Atmmt/quadrotor/电调/AM32_AI8051U-main/docs/pcb/kicad/Am32stc8051u.kicad_pcb

## KiCad design 电调/AM32_AI8051U-main/docs/pcb/kicad/Am32stc8051u.kicad_pcb (2026-05-19, last stored version)

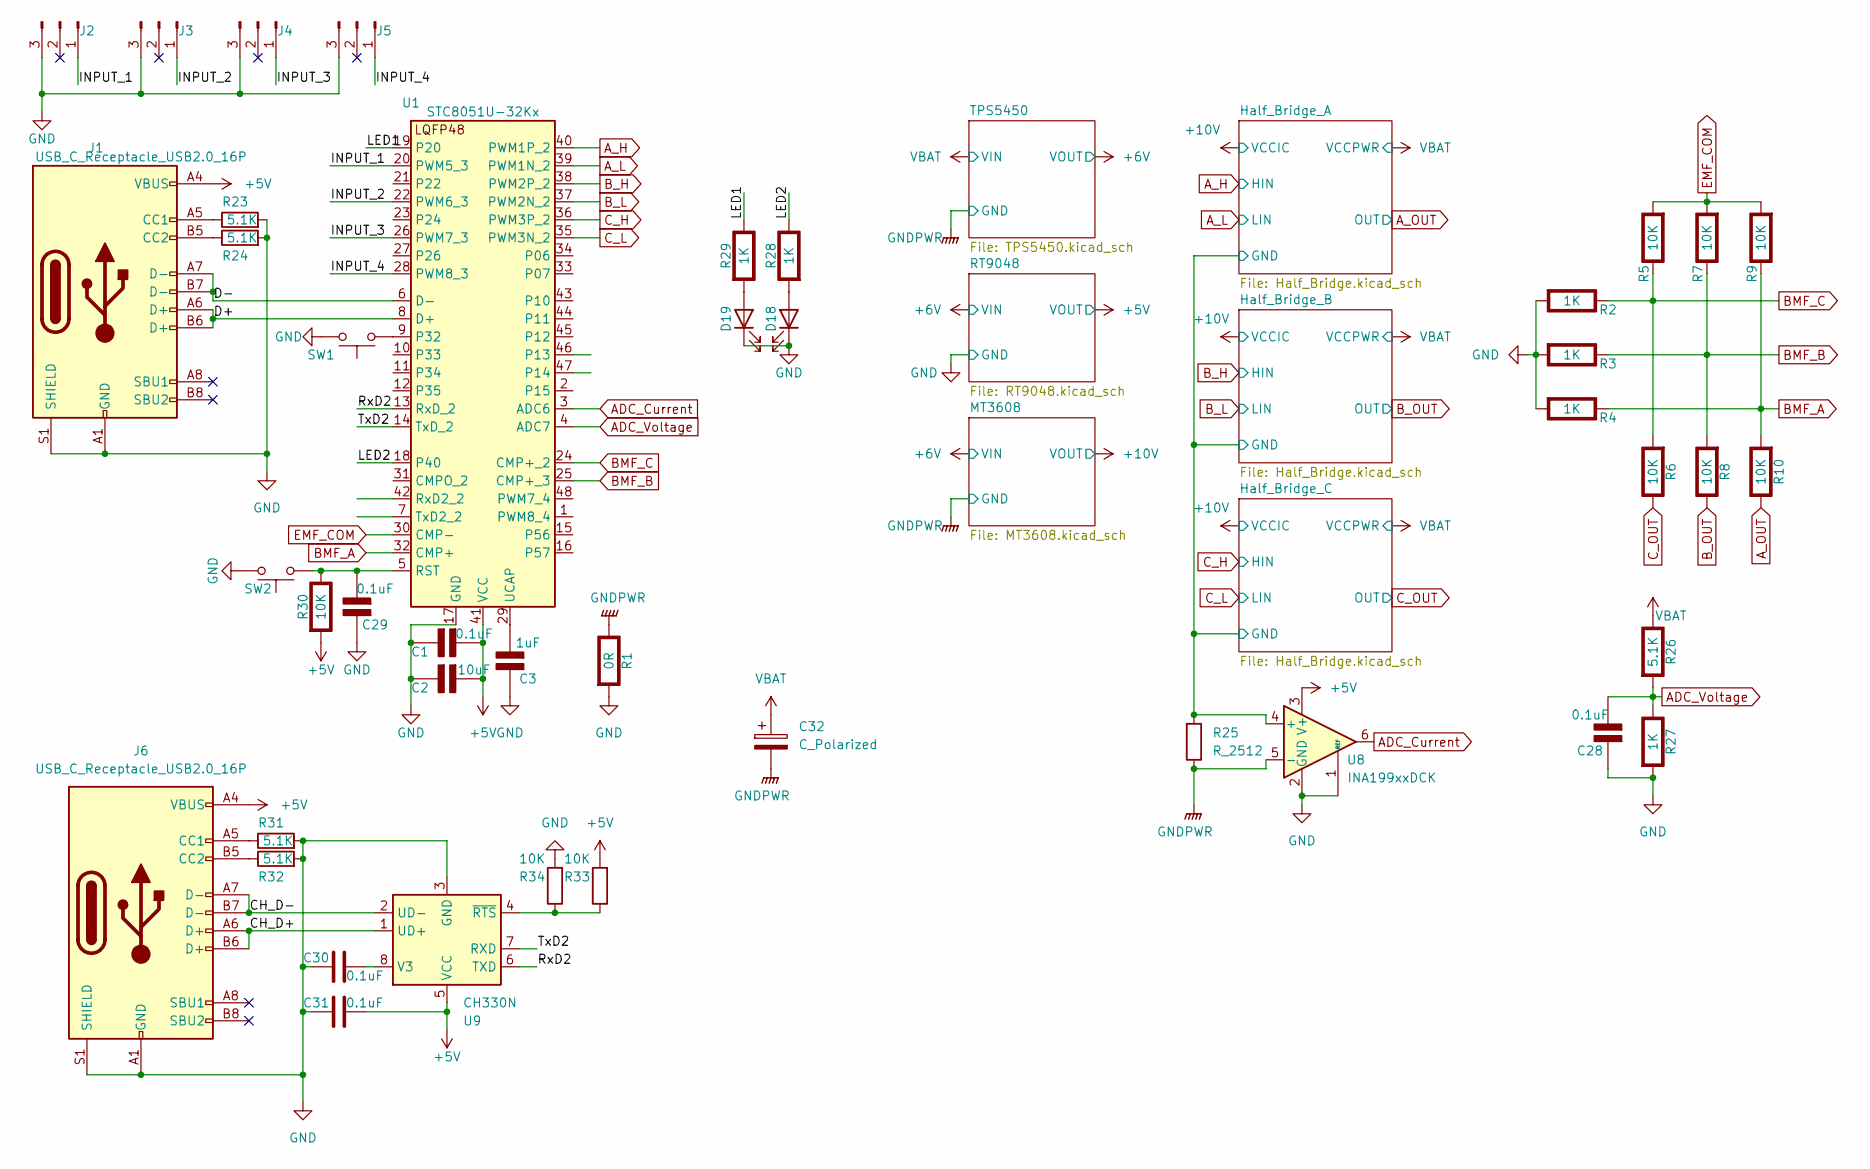
[picture p1: schematic Am32stc8051u.kicad_sch]

Parts:
C1, C28, C29: 0.1uF; C_0603_1608Metric_Pad1.08x0.95mm_HandSolder; Rating V
C2: 10uF; C_0603_1608Metric_Pad1.08x0.95mm_HandSolder; Rating V
C3: 1uF; C_0603_1608Metric_Pad1.08x0.95mm_HandSolder; Rating V
C30, C31: 0.1uF; C_0603_1608Metric_Pad1.08x0.95mm_HandSolder
C32: C_Polarized; CP_Radial_D10.0mm_P5.00mm
D18, D19: LED; LED_0603_1608Metric_Pad1.05x0.95mm_HandSolder
J1, J6: USB_C_Receptacle_USB2.0_16P; USB_C_Receptacle_GCT_USB4105-xx-A_16P_TopMnt_Horizontal
J2, J3, J4, J5: Conn_01x03_Pin; PinHeader_1x03_P2.54mm_Vertical
R1: 0R; R_0603_1608Metric_Pad0.98x0.95mm_HandSolder; Rating W
R2, R3, R4, R27, R28, R29: 1K; R_0603_1608Metric_Pad0.98x0.95mm_HandSolder; Rating W
R5, R6, R7, R8, R9, R10, R30: 10K; R_0603_1608Metric_Pad0.98x0.95mm_HandSolder; Rating W
R23, R24, R31, R32: 5.1K; R_0603_1608Metric_Pad0.98x0.95mm_HandSolder
R25: R_2512; R_2512_6332Metric
R26: 5.1K; R_0603_1608Metric_Pad0.98x0.95mm_HandSolder; Rating W
R33, R34: 10K; R_0603_1608Metric_Pad0.98x0.95mm_HandSolder
SW1, SW2: SW_Push; SW_SPST_CK_RS282G05A3
U1: STC8051U-32Kx; LQFP-48_7x7mm_P0.5mm
U8: INA199xxDCK; SOT-363_SC-70-6
U9: CH330N; SOIC-8_3.9x4.9mm_P1.27mm

Connections:
+5V: C1.1 (+), C2.1 (+), C31.2, J1.A4 (VBUS), J1.A9 (VBUS), J1.B4 (VBUS), J1.B9 (VBUS), J6.A4 (VBUS), J6.A9 (VBUS), J6.B4 (VBUS), J6.B9 (VBUS), R30.2 (-), R33.2, U1.41 (VCC), U8.3 (V+), U9.5 (VCC); also elsewhere on the board
/CH_D+: J6.A6 (D+), J6.B6 (D+), U9.1 (UD+)
/CH_D-: J6.A7 (D-), J6.B7 (D-), U9.2 (UD-)
/D+: J1.A6 (D+), J1.B6 (D+), U1.8 (D+)
/D-: J1.A7 (D-), J1.B7 (D-), U1.6 (D-)
/Half_Bridge_A/GND: R25.1, U8.4 (+); also elsewhere on the board
/INPUT_1: J2.1, U1.20 (PWM5_3)
/INPUT_2: J3.1, U1.22 (PWM6_3)
/INPUT_3: J4.1, U1.26 (PWM7_3)
/INPUT_4: J5.1, U1.28 (PWM8_3)
/LED1: R29.1 (+), U1.19 (P20)
/LED2: R28.1 (+), U1.18 (P40)
/RxD2: U1.13 (RxD_2), U9.6 (TXD)
/TxD2: U1.14 (TxD_2), U9.7 (RXD)
ADC_Current: U1.3 (ADC6), U8.6
ADC_Voltage: C28.2 (-), R26.2 (-), R27.1 (+), U1.4 (ADC7)
A_H: U1.40 (PWM1P_2); also elsewhere on the board
A_L: U1.39 (PWM1N_2); also elsewhere on the board
A_OUT: R10.1 (+); also elsewhere on the board
BMF_A: R4.1 (+), R9.1 (+), R10.2 (-), U1.32 (CMP+)
BMF_B: R3.1 (+), R7.1 (+), R8.2 (-), U1.25 (CMP+_3)
BMF_C: R2.1 (+), R5.1 (+), R6.2 (-), U1.24 (CMP+_2)
B_H: U1.38 (PWM2P_2); also elsewhere on the board
B_L: U1.37 (PWM2N_2); also elsewhere on the board
B_OUT: R8.1 (+); also elsewhere on the board
C_H: U1.36 (PWM3P_2); also elsewhere on the board
C_L: U1.35 (PWM3N_2); also elsewhere on the board
C_OUT: R6.1 (+); also elsewhere on the board
EMF_COM: R5.2 (-), R7.2 (-), R9.2 (-), U1.30 (CMP-)
GND: C1.2 (-), C2.2 (-), C3.1 (+), C28.1 (+), C29.1 (+), C30.1, C31.1, D18.1 (K), D19.1 (K), J1.A1 (GND), J1.A12 (GND), J1.B1 (GND), J1.B12 (GND), J1.S1 (SHIELD), J2.3, J3.3, J4.3, J5.3, J6.A1 (GND), J6.A12 (GND), J6.B1 (GND), J6.B12 (GND), J6.S1 (SHIELD), R1.2 (-), R2.2 (-), R3.2 (-), R4.2 (-), R23.2, R24.2, R27.2 (-), R31.2, R32.2, R34.2, SW1.1, SW2.1, U1.17 (GND), U8.1 (REF), U8.2 (GND), U9.3 (GND); also elsewhere on the board
GNDPWR: C32.2, R1.1 (+), R25.2, U8.5 (-); also elsewhere on the board
unnamed: C3.2 (-), U1.29 (UCAP)
unnamed: C29.2 (-), R30.1 (+), SW2.2, U1.5 (RST)
unnamed: D18.2 (A), R28.2 (-)
unnamed: D19.2 (A), R29.2 (-)
unnamed: J1.A5 (CC1), R23.1
unnamed: J1.B5 (CC2), R24.1
unnamed: J6.A5 (CC1), R31.1
unnamed: J6.B5 (CC2), R32.1
unnamed: SW1.2, U1.9 (P32)
unnamed: C30.2, U9.8 (V3)
unnamed: R33.1, R34.1, U9.4 (~RTS)
VBAT: C32.1, R26.1 (+); also elsewhere on the board

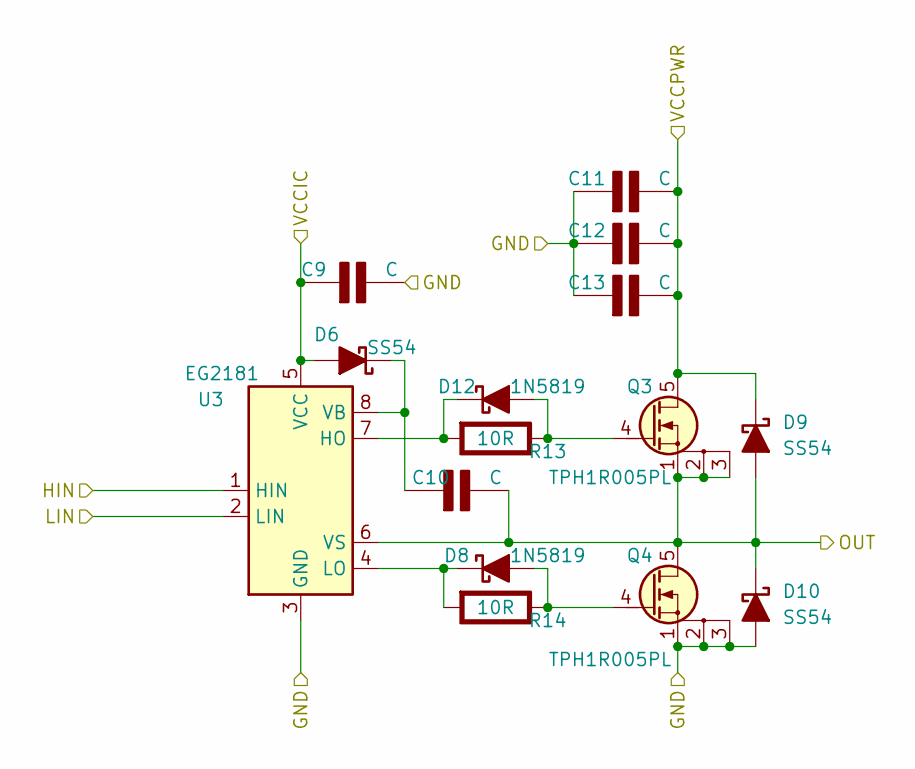
[picture p2: schematic Half_Bridge.kicad_sch]

Parts:
C9: C; C_0805_2012Metric_Pad1.18x1.45mm_HandSolder; Rating V
C10: C; C_0603_1608Metric_Pad1.08x0.95mm_HandSolder; Rating V
C11, C12, C13: C; C_1206_3216Metric_Pad1.33x1.80mm_HandSolder; Rating V
D6, D9, D10: SS54; D_SMA_Handsoldering
D8, D12: 1N5819; D_SOD-323_HandSoldering
Q3, Q4: TPH1R005PL; Infineon_PG-TDSON-8
R13, R14: 10R; R_0603_1608Metric_Pad0.98x0.95mm_HandSolder; Rating W
U3: EG2181; SOP-8_5.28x5.23mm_P1.27mm

Connections:
+10V: C9.1 (+), D6.2 (A), U3.5 (VCC); also elsewhere on the board
/Half_Bridge_A/GND: C9.2 (-), C11.1 (+), C12.1 (+), C13.1 (+), D10.2 (A), Q4.1 (S), Q4.2 (S), Q4.3 (S), U3.3 (GND); also elsewhere on the board
B_H: U3.1 (HIN); also elsewhere on the board
B_L: U3.2 (LIN); also elsewhere on the board
B_OUT: C10.2 (-), D9.2 (A), D10.1 (K), Q3.1 (S), Q3.2 (S), Q3.3 (S), Q4.5 (D), U3.6 (VS); also elsewhere on the board
unnamed: C10.1 (+), D6.1 (K), U3.8 (VB)
unnamed: D8.2 (A), Q4.4 (G), R14.1 (+)
unnamed: D8.1 (K), R14.2 (-), U3.4 (LO)
VBAT: C11.2 (-), C12.2 (-), C13.2 (-), D9.1 (K), Q3.5 (D); also elsewhere on the board

Parts of its further copies:
C4, C14: C; C_0805_2012Metric_Pad1.18x1.45mm_HandSolder; Rating V
C5, C15: C; C_0603_1608Metric_Pad1.08x0.95mm_HandSolder; Rating V
C6, C7, C8, C16, C17, C18: C; C_1206_3216Metric_Pad1.33x1.80mm_HandSolder; Rating V
D1, D4, D5, D11, D14, D15: SS54; D_SMA_Handsoldering
D2, D3, D7, D13: 1N5819; D_SOD-323_HandSoldering
Q1, Q2, Q5, Q6: TPH1R005PL; Infineon_PG-TDSON-8
R11, R12, R15, R16: 10R; R_0603_1608Metric_Pad0.98x0.95mm_HandSolder; Rating W
U2, U4: EG2181; SOP-8_5.28x5.23mm_P1.27mm

Connections of its further copies:
+10V: C4.1 (+), C14.1 (+), D1.2 (A), D11.2 (A), U2.5 (VCC), U4.5 (VCC); also elsewhere on the board
/Half_Bridge_A/GND: C4.2 (-), C6.1 (+), C7.1 (+), C8.1 (+), C14.2 (-), C16.1 (+), C17.1 (+), C18.1 (+), D5.2 (A), D15.2 (A), Q2.1 (S), Q2.2 (S), Q2.3 (S), Q6.1 (S), Q6.2 (S), Q6.3 (S), U2.3 (GND), U4.3 (GND); also elsewhere on the board
A_H: U2.1 (HIN); also elsewhere on the board
A_L: U2.2 (LIN); also elsewhere on the board
A_OUT: C5.2 (-), D4.2 (A), D5.1 (K), Q1.1 (S), Q1.2 (S), Q1.3 (S), Q2.5 (D), U2.6 (VS); also elsewhere on the board
C_H: U4.1 (HIN); also elsewhere on the board
C_L: U4.2 (LIN); also elsewhere on the board
C_OUT: C15.2 (-), D14.2 (A), D15.1 (K), Q5.1 (S), Q5.2 (S), Q5.3 (S), Q6.5 (D), U4.6 (VS); also elsewhere on the board
unnamed: C5.1 (+), D1.1 (K), U2.8 (VB)
unnamed: C15.1 (+), D11.1 (K), U4.8 (VB)
unnamed: D2.2 (A), Q1.4 (G), R11.1 (+)
unnamed: D2.1 (K), R11.2 (-), U2.7 (HO)
unnamed: D3.2 (A), Q2.4 (G), R12.1 (+)
unnamed: D3.1 (K), R12.2 (-), U2.4 (LO)
unnamed: D13.2 (A), Q6.4 (G), R16.1 (+)
unnamed: D13.1 (K), R16.2 (-), U4.4 (LO)
VBAT: C6.2 (-), C7.2 (-), C8.2 (-), C16.2 (-), C17.2 (-), C18.2 (-), D4.1 (K), D14.1 (K), Q1.5 (D), Q5.5 (D); also elsewhere on the board

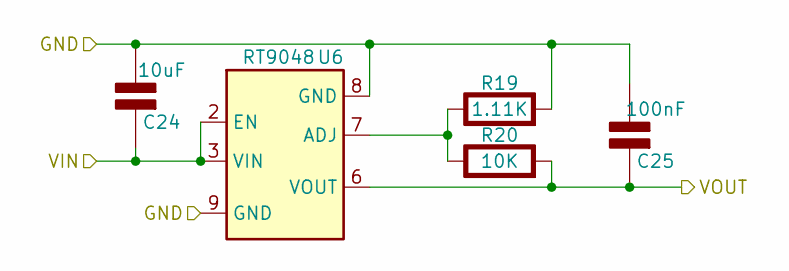
[picture p3: schematic RT9048.kicad_sch]

Parts:
C24: 10uF; C_0603_1608Metric_Pad1.08x0.95mm_HandSolder; Rating V
C25: 100nF; C_0603_1608Metric_Pad1.08x0.95mm_HandSolder; Rating V
R19: 1.11K; R_0603_1608Metric_Pad0.98x0.95mm_HandSolder; Rating W
R20: 10K; R_0603_1608Metric_Pad0.98x0.95mm_HandSolder; Rating W
U6: RT9048; HSOP-8-1EP_3.9x4.9mm_P1.27mm_EP2.3x2.3mm

Connections:
+5V: C25.1 (+), R20.2 (-), U6.6 (VOUT); also elsewhere on the board
+6V: C24.1 (+), U6.2 (EN), U6.3 (VIN); also elsewhere on the board
GND: C24.2 (-), C25.2 (-), R19.2 (-), U6.8 (GND), U6.9 (GND); also elsewhere on the board
unnamed: R19.1 (+), R20.1 (+), U6.7 (ADJ)

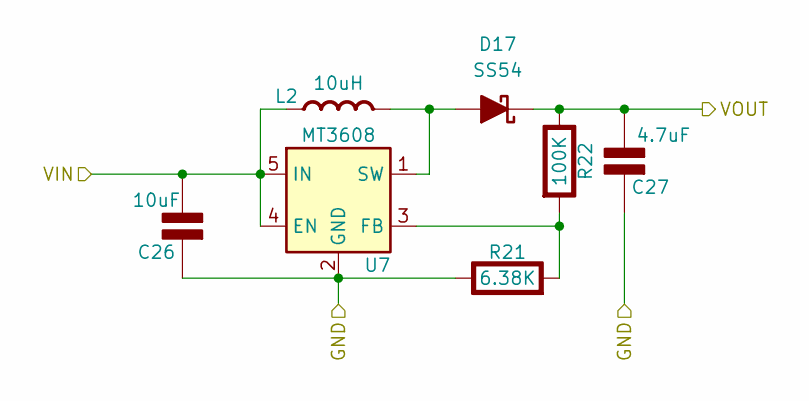
[picture p4: schematic MT3608.kicad_sch]

Parts:
C26: 10uF; C_0603_1608Metric_Pad1.08x0.95mm_HandSolder; Rating V
C27: 4.7uF; C_0603_1608Metric_Pad1.08x0.95mm_HandSolder; Rating V
D17: SS54; D_SMA_Handsoldering
L2: 10uH; L_6.3x6.3_H3; Rating A
R21: 6.38K; R_0603_1608Metric_Pad0.98x0.95mm_HandSolder; Rating W
R22: 100K; R_0603_1608Metric_Pad0.98x0.95mm_HandSolder; Rating W
U7: MT3608; SOT-23-6

Connections:
+6V: C26.2 (-), L2.1 (+), U7.4 (EN), U7.5 (IN); also elsewhere on the board
+10V: C27.2 (-), D17.1 (K), R22.1 (+); also elsewhere on the board
GNDPWR: C26.1 (+), C27.1 (+), R21.1 (+), U7.2 (GND); also elsewhere on the board
unnamed: D17.2 (A), L2.2 (-), U7.1 (SW)
unnamed: R21.2 (-), R22.2 (-), U7.3 (FB)

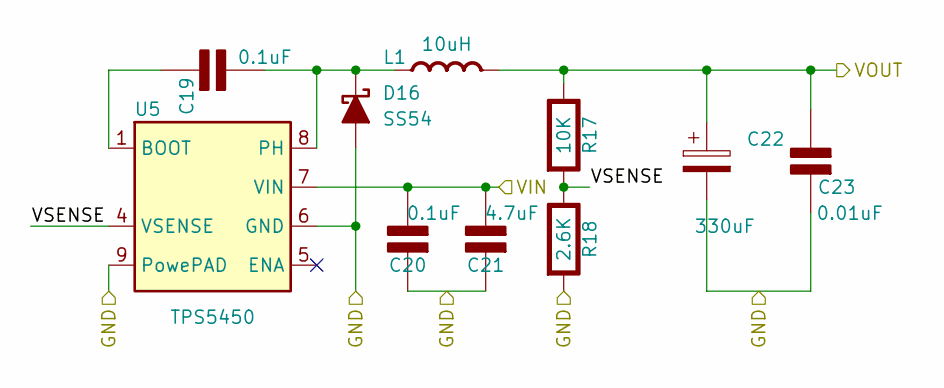
[picture p5: schematic TPS5450.kicad_sch]

Parts:
C19, C20: 0.1uF; C_0603_1608Metric_Pad1.08x0.95mm_HandSolder; Rating V
C21: 4.7uF; C_0603_1608Metric_Pad1.08x0.95mm_HandSolder; Rating V
C22: 330uF; CP_EIA-6032-15_Kemet-U_Pad2.25x2.35mm_HandSolder
C23: 0.01uF; C_0603_1608Metric_Pad1.08x0.95mm_HandSolder; Rating V
D16: SS54; D_SMA_Handsoldering
L1: 10uH; L_6.3x6.3_H3; Rating A
R17: 10K; R_0603_1608Metric_Pad0.98x0.95mm_HandSolder; Rating W
R18: 2.6K; R_0603_1608Metric_Pad0.98x0.95mm_HandSolder; Rating W
U5: TPS5450; SOIC-8-1EP_3.9x4.9mm_P1.27mm_EP2.29x3mm

Connections:
+6V: C22.1, C23.2 (-), L1.2 (-), R17.1 (+); also elsewhere on the board
/TPS5450/VSENSE: R17.2 (-), R18.1 (+), U5.4 (VSENSE)
GNDPWR: C20.1 (+), C21.1 (+), C22.2, C23.1 (+), D16.2 (A), R18.2 (-), U5.6 (GND), U5.9 (PowePAD); also elsewhere on the board
unnamed: C19.1 (+), U5.1 (BOOT)
unnamed: C19.2 (-), D16.1 (K), L1.1 (+), U5.8 (PH)
VBAT: C20.2 (-), C21.2 (-), U5.7 (VIN); also elsewhere on the board

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
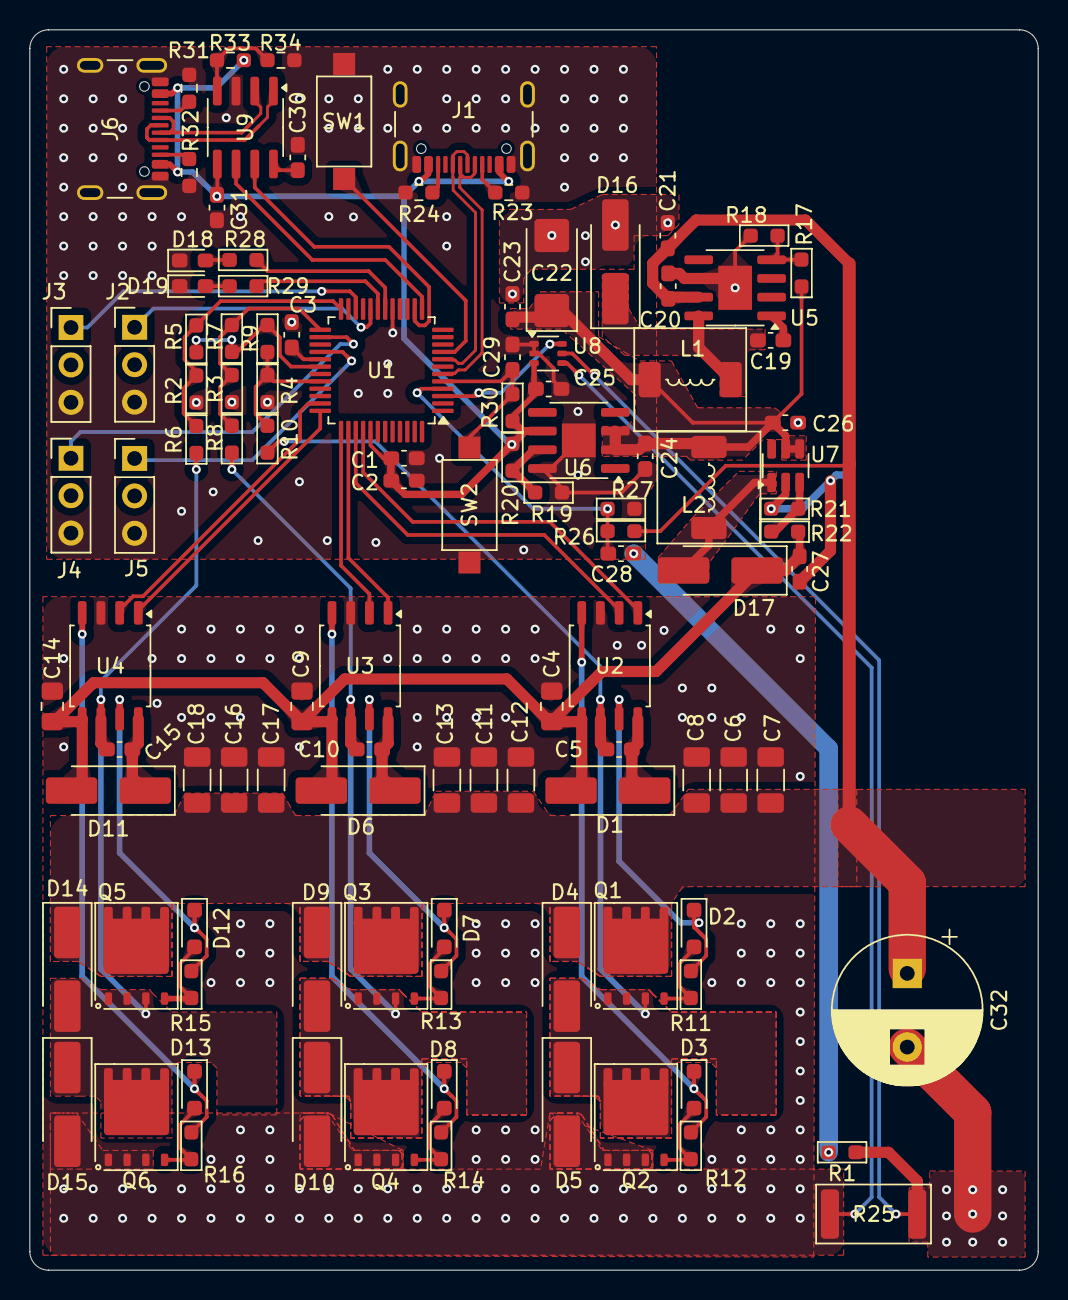
[picture p6: board Am32stc8051u.kicad_pcb from above]

Board: 2 copper layers, 68.5 x 84.2 mm, 110 parts (0 on the bottom side), 66 nets.
