Atmmt/quadrotor/2.应用控制/cyt4-bb7_-control_-middleware/PROJECT/code/BSP/Inc/bsp_imu.h

#ifndef __BSP_IMU_H
#define __BSP_IMU_H

#include <stdint.h>

typedef struct{ //中间私有变量
	float x;
	float y;
	float z;
}PrivateBuf_t;
	
typedef struct{
	PrivateBuf_t gyro; //3轴角速度
	PrivateBuf_t accel;//3轴加速度
	PrivateBuf_t magn;//3轴磁力计
}IMU_DATA_t;

typedef struct{
	float roll;
	float pitch;
	float yaw;
}ATTITUDE_DATA_t;


//IMU操作接口
typedef struct {
    uint8_t (*Init)(void);
    void (*UpdateZeroPoint_axis)(const IMU_DATA_t* point);               //更新9轴数据零点
    void (*UpdateZeroPoint_attitude)(const ATTITUDE_DATA_t* attitude);   //更新姿态零点
    void (*Update_9axisVal)(IMU_DATA_t* imudata);                         //更新9轴数据
    void (*UpdateAttitude)(IMU_DATA_t imudata,ATTITUDE_DATA_t *attitude); //更新姿态角
	
}IMUInterface_t,*pIMUInterface_t;

extern IMUInterface_t UserIMU963RA;


#endif /* __BSP_IMU_H */
