Atmmt/quadrotor/2.应用控制/cyt4-bb7_-control_-middleware/PROJECT/code/BSP/bsp_RTOSdebug.c

#include "bsp_RTOSdebug.h"
#include "zf_common_headfile.h"
#include "math.h"

//定时器频率,单位为Hz.根据配置不同修改
#define TIM_FREQ 1000000

static void timer2ch2_init(void)
{
  timer_init(TC_TIME2_CH2,TIMER_US);
  timer_start(TC_TIME2_CH2);
}
static uint16_t get_TickCount(void)
{
    //获取计数值的方法.注意该数值跟定时器配置有关,当前配置为 0.01ms 计数1
    return timer_get(TC_TIME2_CH2);
}

//获取debug计时的方法
static void get_StartCount(RtosDebugPrivateVar* priv_var)
{
    //0替换为读取计数的方法
    priv_var->TickLast = get_TickCount();
}

//获取频率的方法,注意：频率过慢无法检测,这里只处理了1次定时器数据溢出情况
static uint16_t get_Freq(RtosDebugPrivateVar* priv_var)
{
    priv_var->countState = !priv_var->countState;

    if( 1 == priv_var->countState )
        priv_var->TickLast = get_TickCount(),//保存1次计数
        priv_var->TaskFreq = priv_var->LastFreq;
    else
    {
        //第二次进入,开始计算频率
        priv_var->TickNow = get_TickCount();
        if( priv_var->TickNow < priv_var->TickLast )
        {   //数值溢出了
            priv_var->TaskFreq = priv_var->TickNow + 0xFFFF - priv_var->TickLast;
        }
        else
            priv_var->TaskFreq = priv_var->TickNow - priv_var->TickLast;

        priv_var->TaskFreq = round((float)TIM_FREQ/(float)priv_var->TaskFreq);
        priv_var->LastFreq = priv_var->TaskFreq;
    }

    return priv_var->TaskFreq;
}

//获取函数运行时间的方法,注意需要计时开始端使用 TickStart方法保存1次计数值
static float get_UsedTime(RtosDebugPrivateVar* priv_var)
{
    //获取计数
    priv_var->TickNow = get_TickCount();

    //上一次数据比本次获取的值大,说明计数溢出了
    if( priv_var->TickLast > priv_var->TickNow )  
    {
        priv_var->UseTime = priv_var->TickNow + 0xFFFF - priv_var->TickLast;
    }
    else
        priv_var->UseTime = priv_var->TickNow - priv_var->TickLast;
    
    priv_var->UseTime = ((float)priv_var->UseTime/(float)TIM_FREQ)*1000;//转换为ms单位输出

    return priv_var->UseTime;
}

//驱动挂载
RtosDebugInterface_t UserSoft_TimerDebug = {
    .init = timer2ch2_init,
    .TickStart = get_StartCount,
    .UpdateFreq = get_Freq,
    .UpdateUsedTime = get_UsedTime,
};
